denisgav/rpi_pico_w_a2dp_sink_demo/Firmware/app/usb_stereo_microphone/README.md

# USB stereo microphone
Microphone rupports several formats:
  * 24 / 16 bit samples
  * 16000 / 32000 / 48000 Hz sample rates
