denisgav/rpi_pico_w_a2dp_sink_demo/Firmware/app/usb_stereo_speaker/README.md

# USB stereo speaker
Speaker rupports several formats:
  * 24 / 16 bit samples
  * 44100 / 48000 Hz sample rates
