denisgav/rpi_pico_w_a2dp_sink_demo/KiCad/components/AudioJack_3.5mm_PJ311/AudioJack_3.5mm_PJ311.step

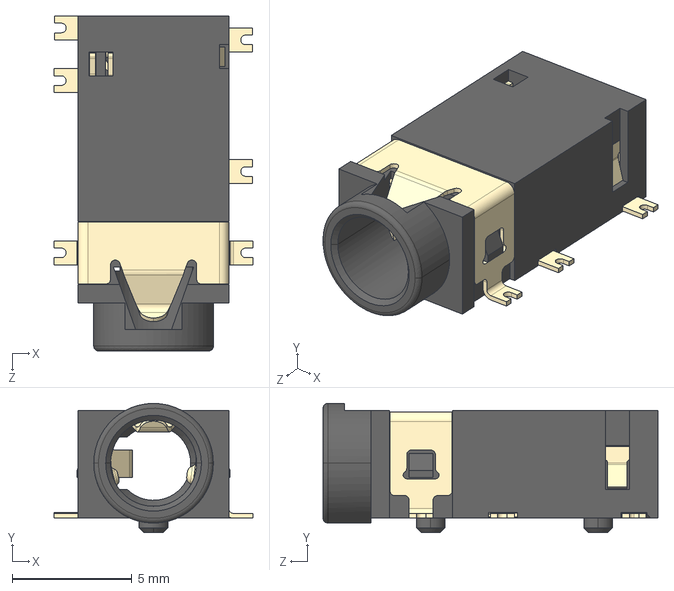
[picture p1: CAD file, 2025-04-05]
KiCad/components/AudioJack_3.5mm_PJ311/AudioJack_3.5mm_PJ311.step
8.30 x 5.40 x 14.0 mm
