denisgav/rpi_pico_w_a2dp_sink_demo/KiCad/components/CR1220-2/CR1220-2.stp

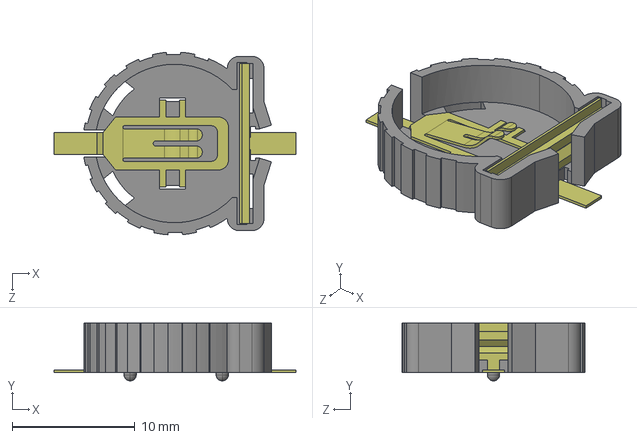
[picture p2: CAD file, 2025-04-05]
KiCad/components/CR1220-2/CR1220-2.stp
19.7 x 4.70 x 14.9 mm
