denisgav/rpi_pico_w_a2dp_sink_demo/KiCad/components/inmp441/inmp441.step

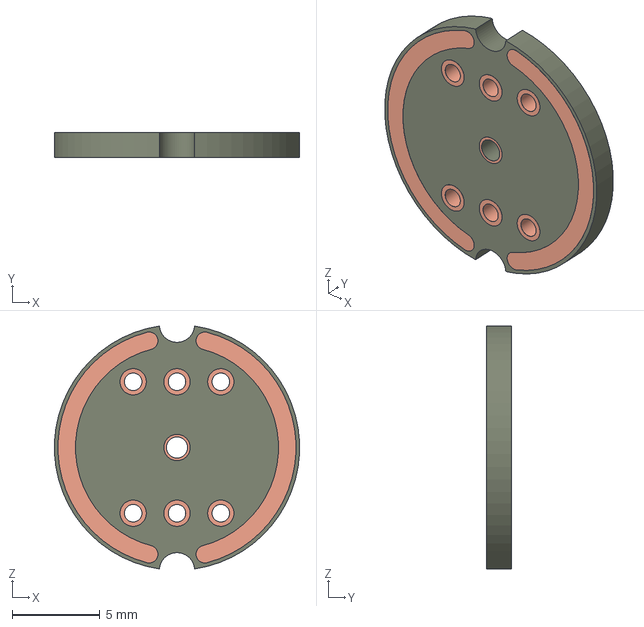
[picture p3: CAD file, 2025-04-05]
KiCad/components/inmp441/inmp441.step
14.0 x 1.41 x 13.9 mm
