denisgav/rpi_pico_w_a2dp_sink_demo/KiCad/components/Power/Barrel_Jack/BarrelJack-PJ-102AH.step

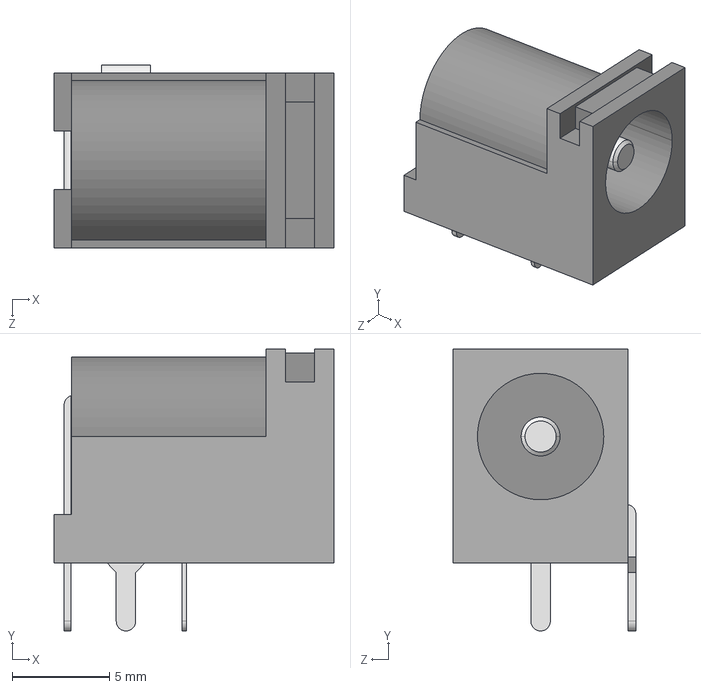
[picture p4: CAD file, 2025-04-05]
KiCad/components/Power/Barrel_Jack/BarrelJack-PJ-102AH.step
14.4 x 14.5 x 9.40 mm
