denisgav/rpi_pico_w_a2dp_sink_demo/KiCad/components/Power/LS1205EVD33/LS1205EVD33.stp

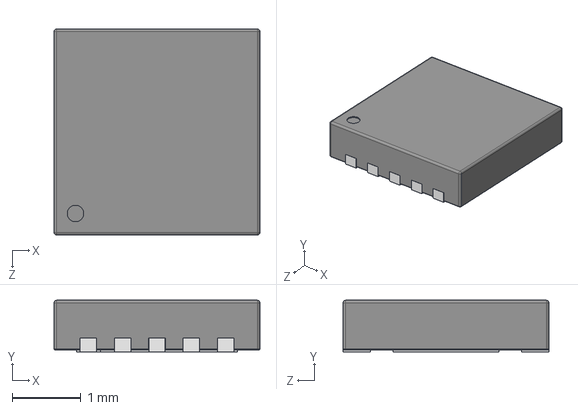
[picture p5: CAD file, 2025-04-05]
KiCad/components/Power/LS1205EVD33/LS1205EVD33.stp
3.00 x 0.75 x 3.00 mm
