denisgav/rpi_pico_w_a2dp_sink_demo/KiCad/components/Power/SY8003ADFC/SY8003ADFC.stp

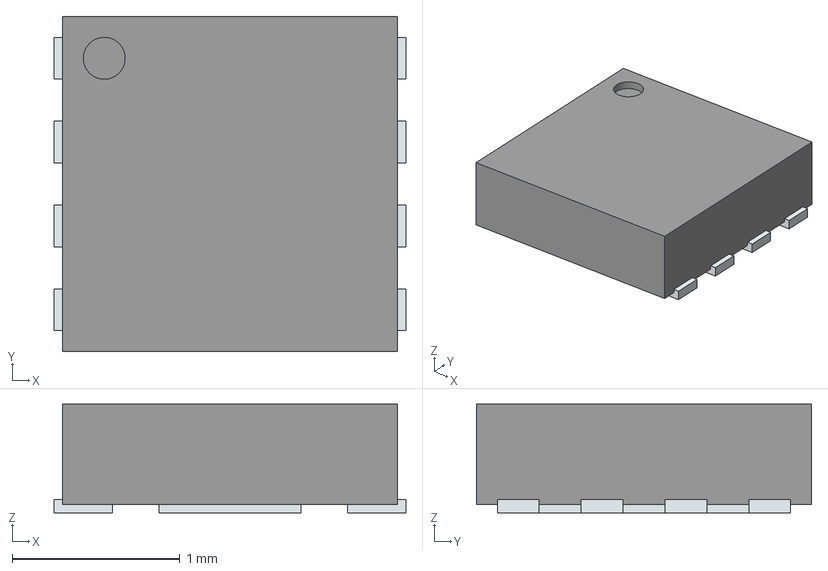
[picture p6: CAD file, 2025-04-05]
KiCad/components/Power/SY8003ADFC/SY8003ADFC.stp
2.10 x 2.00 x 0.65 mm
ThermalPin
PinsArrayLR
