denisgav/rpi_pico_w_a2dp_sink_demo/KiCad/components/sw_dpdt_xlx/SW_Btn_XLX.step

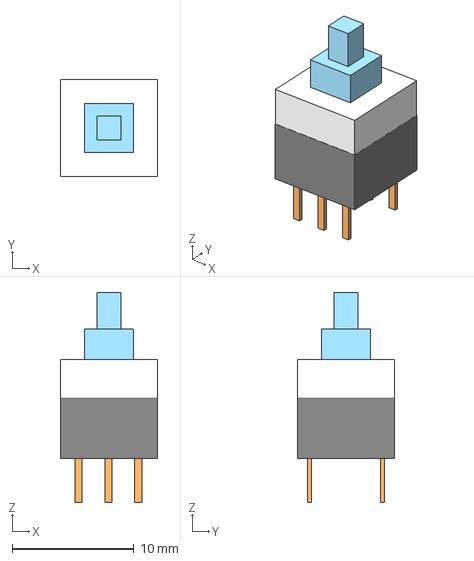
[picture p7: CAD file, 2025-04-05]
KiCad/components/sw_dpdt_xlx/SW_Btn_XLX.step
8.00 x 8.00 x 17.2 mm
