denisgav/rpi_pico_w_a2dp_sink_demo/KiCad/components/SW_PUSH_6mm_H5mm/SW_PUSH_6mm_H5mm.step

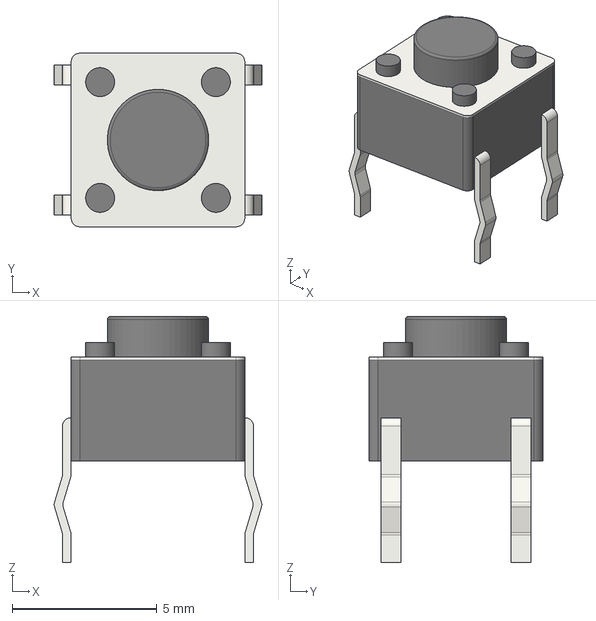
[picture p8: CAD file, 2025-04-05]
KiCad/components/SW_PUSH_6mm_H5mm/SW_PUSH_6mm_H5mm.step
7.17 x 6.00 x 8.50 mm
