denisgav/rpi_pico_w_a2dp_sink_demo/KiCad/components/TF-01A/TF-01A.stp

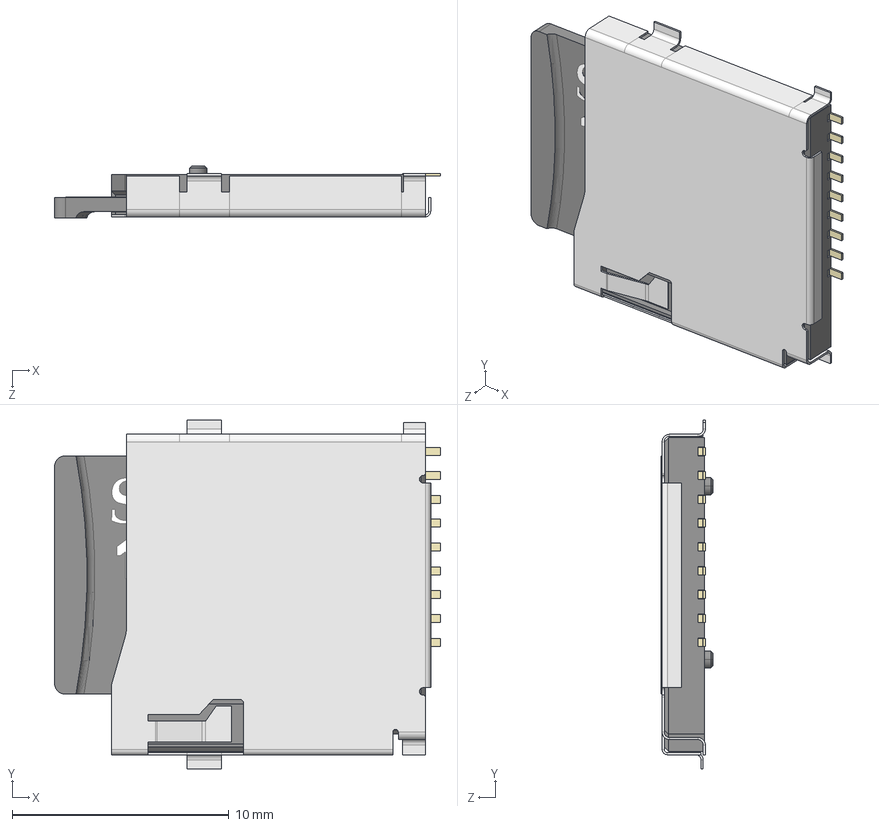
[picture p9: CAD file, 2025-04-05]
KiCad/components/TF-01A/TF-01A.stp
17.8 x 16.1 x 2.40 mm
