denisgav/rpi_pico_w_a2dp_sink_demo/KiCad/rpi_pico_media_board.kicad_pcb

## KiCad design KiCad/rpi_pico_media_board.kicad_pcb (2025-05-18)

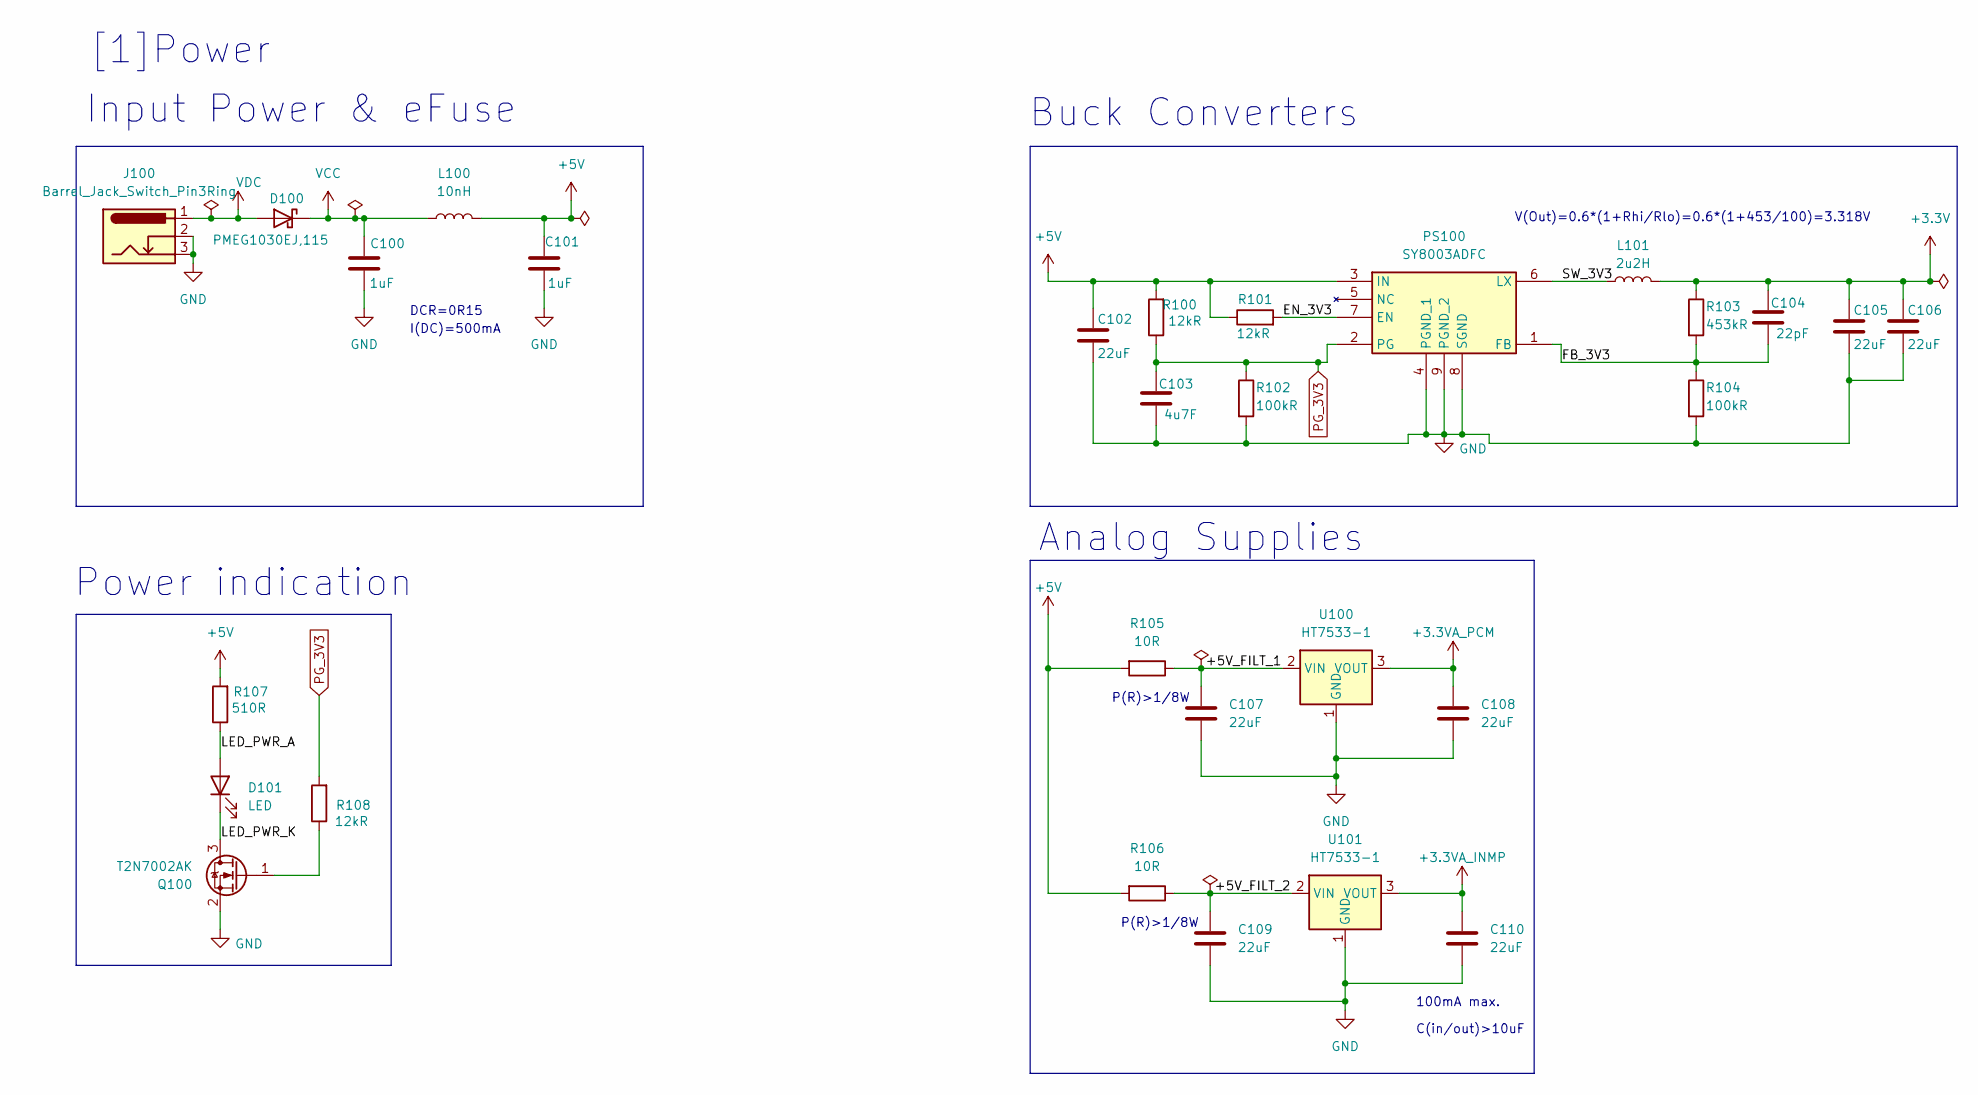
[picture p10: schematic [1]Power.kicad_sch]

Parts:
C100, C101: 1uF; C_0603_1608Metric; Manufacturer Part Number CL10A105KB8NNNC
C102, C105, C106, C107, C108, C109, C110: 22uF; C_1206_3216Metric; Manufacturer Part Number CS3216X5R226M160NRI
C103: 4u7F; C_0603_1608Metric; Manufacturer Part Number CL10A475KP8NNNC
C104: 22pF; C_0603_1608Metric; Manufacturer Part Number CL10C220JB8NNNC
D100: PMEG1030EJ,115; D_SOD-323F; Manufacturer Part Number PMEG1030EJ,115
D101: LED; LED_0603_1608Metric; Manufacturer Part Number XL-1608SURC-06
J100: Barrel_Jack_Switch_Pin3Ring; BarrelJack_GCT_DCJ200-10-A_Horizontal; Manufacturer Part Number DC005
L100: 10nH; L_0603_1608Metric; Manufacturer Part Number LQW18AN10NG10D
L101: 2u2H; L_1008_2520Metric; Manufacturer Part Number DFE252012F-2R2M=P2
PS100: SY8003ADFC; SON50P200X200X65-9N; Manufacturer Part Number SY8003ADFC
Q100: T2N7002AK; SOT-23; Manufacturer Part Number T2N7002AK,LM
R100, R101, R108: 12kR; R_0603_1608Metric; Manufacturer Part Number 0603WAF1202T5E
R102, R104: 100kR; R_0603_1608Metric; Manufacturer Part Number 0603WAF1003T5E
R103: 453kR; R_0603_1608Metric; Manufacturer Part Number 0603WAF4533T5E
R105, R106: 10R; R_0805_2012Metric; Manufacturer Part Number 0805W8F100JT5E
R107: 510R; R_0603_1608Metric; Manufacturer Part Number 0603WAF5100T5E
U100, U101: HT7533-1; SOT-89-3; Manufacturer Part Number HT7533-1

Connections:
+3.3V: C104.1, C105.1, C106.1, L101.2, R103.1; also elsewhere on the board
+3.3VA_INMP: C110.1, U101.3 (VOUT); also elsewhere on the board
+3.3VA_PCM: C108.1, U100.3 (VOUT); also elsewhere on the board
+5V: C101.1, C102.1, L100.2, PS100.3 (IN), R100.2, R101.1, R105.2, R106.2, R107.2; also elsewhere on the board
/[1]Power/+5V_FILT_1: C107.1, R105.1, U100.2 (VIN)
/[1]Power/+5V_FILT_2: C109.1, R106.1, U101.2 (VIN)
/[1]Power/EN_3V3: PS100.7 (EN), R101.2
/[1]Power/FB_3V3: C104.2, PS100.1 (FB), R103.2, R104.1
/[1]Power/LED_PWR_A: D101.2 (A), R107.1
/[1]Power/LED_PWR_K: D101.1 (K), Q100.3 (D)
/[1]Power/SW_3V3: L101.1, PS100.6 (LX)
GND: C100.2, C101.2, C102.2, C103.2, C105.2, C106.2, C107.2, C108.2, C109.2, C110.2, J100.2, J100.3, PS100.4 (PGND_1), PS100.8 (SGND), PS100.9 (PGND_2), Q100.2 (S), R102.2, R104.2, U100.1 (GND), U101.1 (GND); also elsewhere on the board
unnamed: Q100.1 (G), R108.1
PG_3V3: C103.1, PS100.2 (PG), R100.1, R102.1, R108.2
VCC: C100.1, D100.1 (K), L100.1; also elsewhere on the board
VDC: D100.2 (A), J100.1

Notes on the sheet:
Analog Supplies
Power indication
P(R)>1/8W
I(DC)=500mA
Input Power & eFuse
100mA max.
[1]Power
DCR=0R15
C(in/out)>10uF
V(Out)=0.6*(1+Rhi/Rlo)=0.6*(1+453/100)=3.318V
Buck Converters

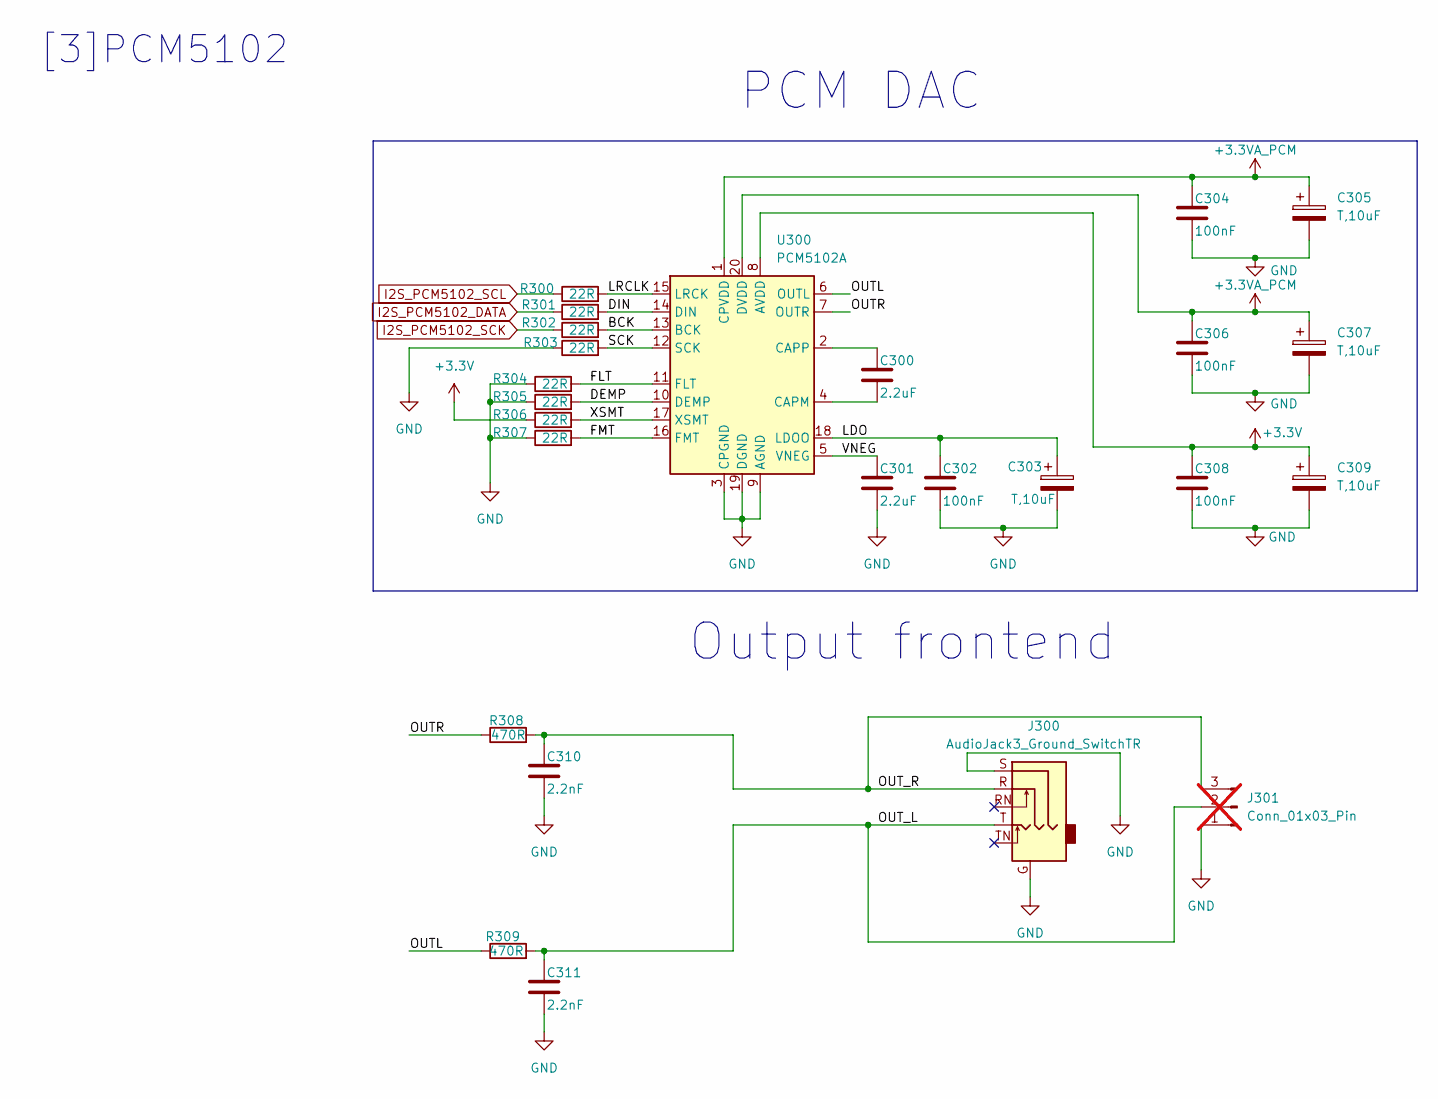
[picture p11: schematic [3]PCM5102.kicad_sch]

Parts:
C300, C301: 2.2uF; C_0603_1608Metric; Manufacturer Part Number CL10A225KA8NNNC
C302, C304, C306, C308: 100nF; C_0603_1608Metric; Manufacturer Part Number CL10B104KA8NNNC
C303, C305, C307, C309: T,10uF; CP_EIA-3216-18_Kemet-A; Manufacturer Part Number TAJA106K016RNJ
C310, C311: 2.2nF; C_0603_1608Metric; Manufacturer Part Number CL10B222KB8NNNC
J300: AudioJack3_Ground_SwitchTR; AudioJack_3.5mm_PJ311; Manufacturer Part Number PJ-342
J301: Conn_01x03_Pin; PinHeader_1x03_P2.54mm_Vertical; not fitted
R300, R301, R302, R303, R304, R305, R306, R307: 22R; R_0603_1608Metric; Manufacturer Part Number 0603WAF220JT5E
R308, R309: 470R; R_0805_2012Metric; Manufacturer Part Number ARG05FTC4700
U300: PCM5102A; TSSOP-20_4.4x6.5mm_P0.65mm; Manufacturer Part Number PCM5102AQPWRQ1

Connections:
+3.3V: C308.1, C309.1, R306.1, U300.8 (AVDD); also elsewhere on the board
+3.3VA_PCM: C304.1, C305.1, C306.1, C307.1, U300.1 (CPVDD), U300.20 (DVDD); also elsewhere on the board
/[3]PCM5102/BCK: R302.2, U300.13 (BCK)
/[3]PCM5102/DEMP: R305.2, U300.10 (DEMP)
/[3]PCM5102/DIN: R301.2, U300.14 (DIN)
/[3]PCM5102/FLT: R304.2, U300.11 (FLT)
/[3]PCM5102/FMT: R307.2, U300.16 (FMT)
/[3]PCM5102/LDO: C302.1, C303.1, U300.18 (LDOO)
/[3]PCM5102/LRCLK: R300.2, U300.15 (LRCK)
/[3]PCM5102/OUTL: R309.1, U300.6 (OUTL)
/[3]PCM5102/OUTR: R308.1, U300.7 (OUTR)
/[3]PCM5102/OUT_L: C311.1, J300.T, J301.2, R309.2
/[3]PCM5102/OUT_R: C310.1, J300.R, J301.3, R308.2
/[3]PCM5102/SCK: R303.2, U300.12 (SCK)
/[3]PCM5102/VNEG: C301.1, U300.5 (VNEG)
/[3]PCM5102/XSMT: R306.2, U300.17 (XSMT)
GND: C301.2, C302.2, C303.2, C304.2, C305.2, C306.2, C307.2, C308.2, C309.2, C310.2, C311.2, J300.G, J300.S, J301.1, R303.1, R304.1, R305.1, R307.1, U300.3 (CPGND), U300.9 (AGND), U300.19 (DGND); also elsewhere on the board
I2S_PCM5102_DATA: R301.1; also elsewhere on the board
I2S_PCM5102_SCK: R302.1; also elsewhere on the board
I2S_PCM5102_SCL: R300.1; also elsewhere on the board
unnamed: C300.2, U300.4 (CAPM)
unnamed: C300.1, U300.2 (CAPP)

Notes on the sheet:
[3]PCM5102
Output frontend
PCM DAC

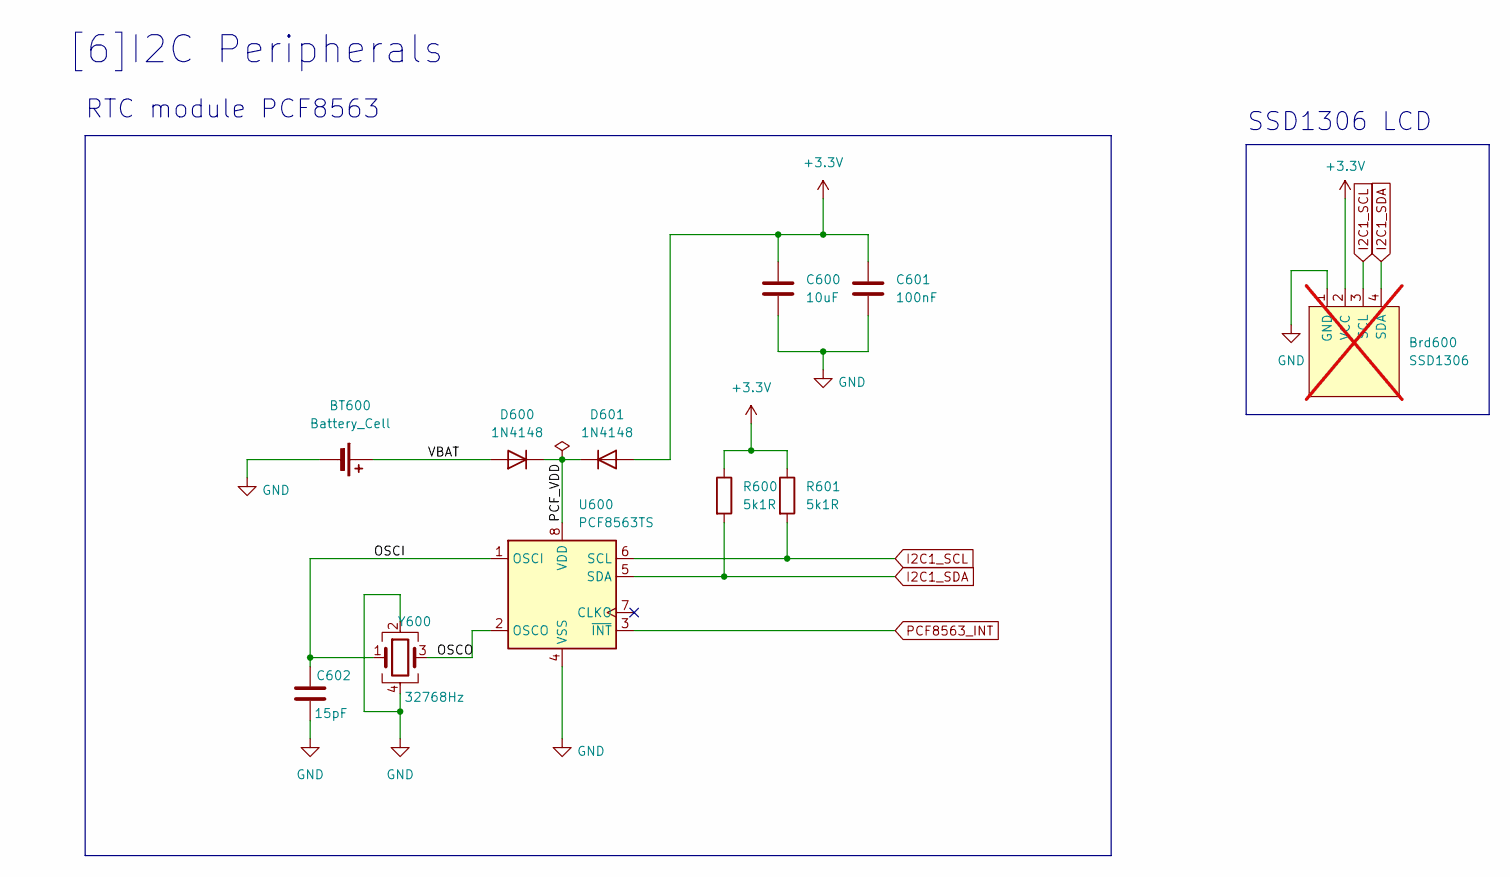
[picture p12: schematic [6]I2C_Peripherals.kicad_sch]

Parts:
BT600: Battery_Cell; CR12202; Manufacturer Part Number CR1220-2
Brd600: SSD1306; 128x64OLED; not fitted
C600: 10uF; C_0603_1608Metric; Manufacturer Part Number CL10A106KP8NNNC
C601: 100nF; C_0603_1608Metric; Manufacturer Part Number CL10B104KA8NNNC
C602: 15pF; C_0603_1608Metric; Manufacturer Part Number CL10C150JB8NNNC; DigiKey Part Number 490-11191-6-ND
D600, D601: 1N4148; D_SOD-123; Manufacturer Part Number 1N4148W
R600, R601: 5k1R; R_0805_2012Metric; Manufacturer Part Number 0805W8F5101T5E
U600: PCF8563TS; MSOP-8_3x3mm_P0.65mm; Manufacturer Part Number PCF8563TS/5,118
Y600: 32768Hz; Crystal_SMD_3225-4Pin_3.2x2.5mm; Manufacturer Part Number OK2EL89CJI-111YLC-32.768K; DigiKey Part Number 535-ASEK-32.768KHZ-L-R-TDKR-ND

Connections:
+3.3V: Brd600.2 (VCC), C600.1, C601.1, D601.2 (A), R600.1, R601.1; also elsewhere on the board
/[6]I2C_Peripherals/OSCI: C602.1, U600.1 (OSCI), Y600.1
/[6]I2C_Peripherals/OSCO: U600.2 (OSCO), Y600.3
/[6]I2C_Peripherals/PCF_VDD: D600.1 (K), D601.1 (K), U600.8 (VDD)
/[6]I2C_Peripherals/VBAT: BT600.1 (+), D600.2 (A)
GND: BT600.2 (-), Brd600.1 (GND), C600.2, C601.2, C602.2, U600.4 (VSS), Y600.2, Y600.4; also elsewhere on the board
I2C1_SCL: Brd600.3 (SCL), R601.2, U600.6 (SCL); also elsewhere on the board
I2C1_SDA: Brd600.4 (SDA), R600.2, U600.5 (SDA); also elsewhere on the board
PCF8563_INT: U600.3 (~INT); also elsewhere on the board

Notes on the sheet:
[6]I2C Peripherals
SSD1306 LCD
RTC module PCF8563

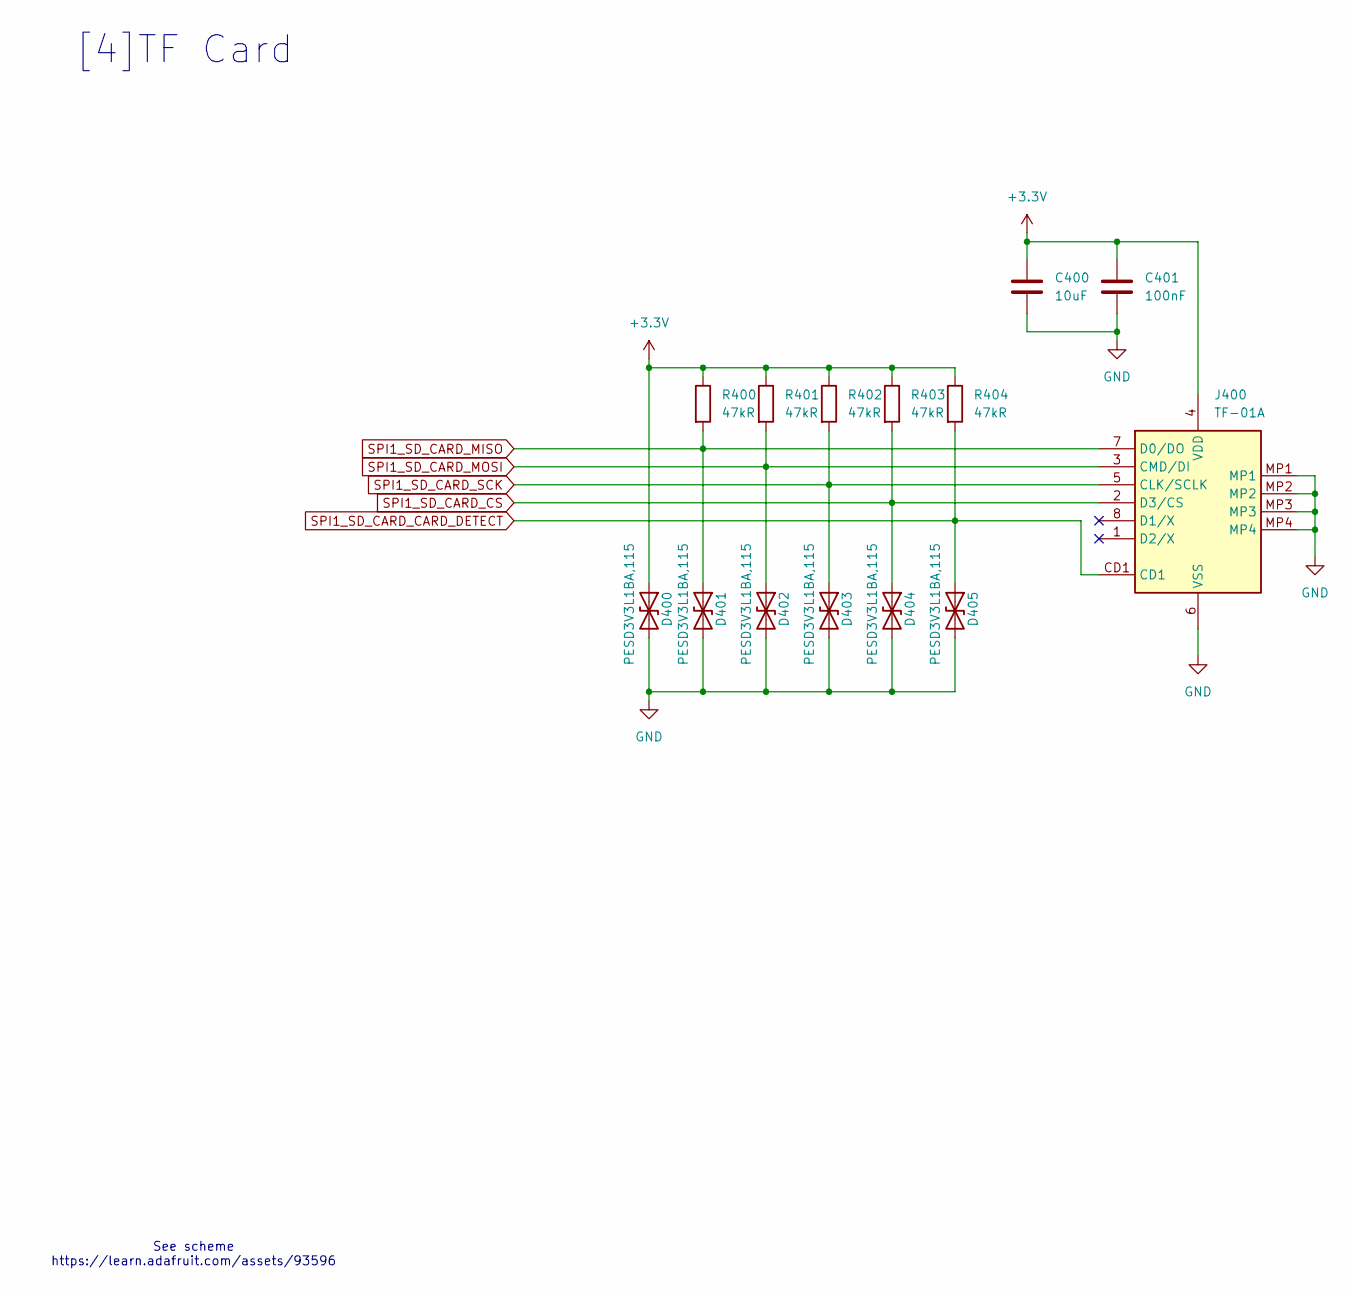
[picture p13: schematic [4]TF_CARD.kicad_sch]

Parts:
C400: 10uF; C_0603_1608Metric; Manufacturer Part Number CL10A106KP8NNNC
C401: 100nF; C_0603_1608Metric; Manufacturer Part Number CL10B104KA8NNNC
D400, D401, D402, D403, D404, D405: PESD3V3L1BA,115; D_SOD-323; Manufacturer Part Number PESD3V3L1BA,115
J400: TF-01A; TF01A; Manufacturer Part Number TF-01A
R400, R401, R402, R403, R404: 47kR; R_0603_1608Metric; Manufacturer Part Number 0603WAJ0473T5E

Connections:
+3.3V: C400.1, C401.1, D400.1 (A1), J400.4 (VDD), R400.1, R401.1, R402.1, R403.1, R404.1; also elsewhere on the board
GND: C400.2, C401.2, D400.2 (A2), D401.2 (A2), D402.2 (A2), D403.2 (A2), D404.2 (A2), D405.2 (A2), J400.6 (VSS), J400.MP1, J400.MP2, J400.MP3, J400.MP4; also elsewhere on the board
SPI1_SD_CARD_CARD_DETECT: D405.1 (A1), J400.CD1, R404.2; also elsewhere on the board
SPI1_SD_CARD_CS: D404.1 (A1), J400.2 (D3/CS), R403.2; also elsewhere on the board
SPI1_SD_CARD_MISO: D401.1 (A1), J400.7 (D0/DO), R400.2; also elsewhere on the board
SPI1_SD_CARD_MOSI: D402.1 (A1), J400.3 (CMD/DI), R401.2; also elsewhere on the board
SPI1_SD_CARD_SCK: D403.1 (A1), J400.5 (CLK/SCLK), R402.2; also elsewhere on the board

Notes on the sheet:
See scheme https://learn.adafruit.com/assets/93596
[4]TF Card

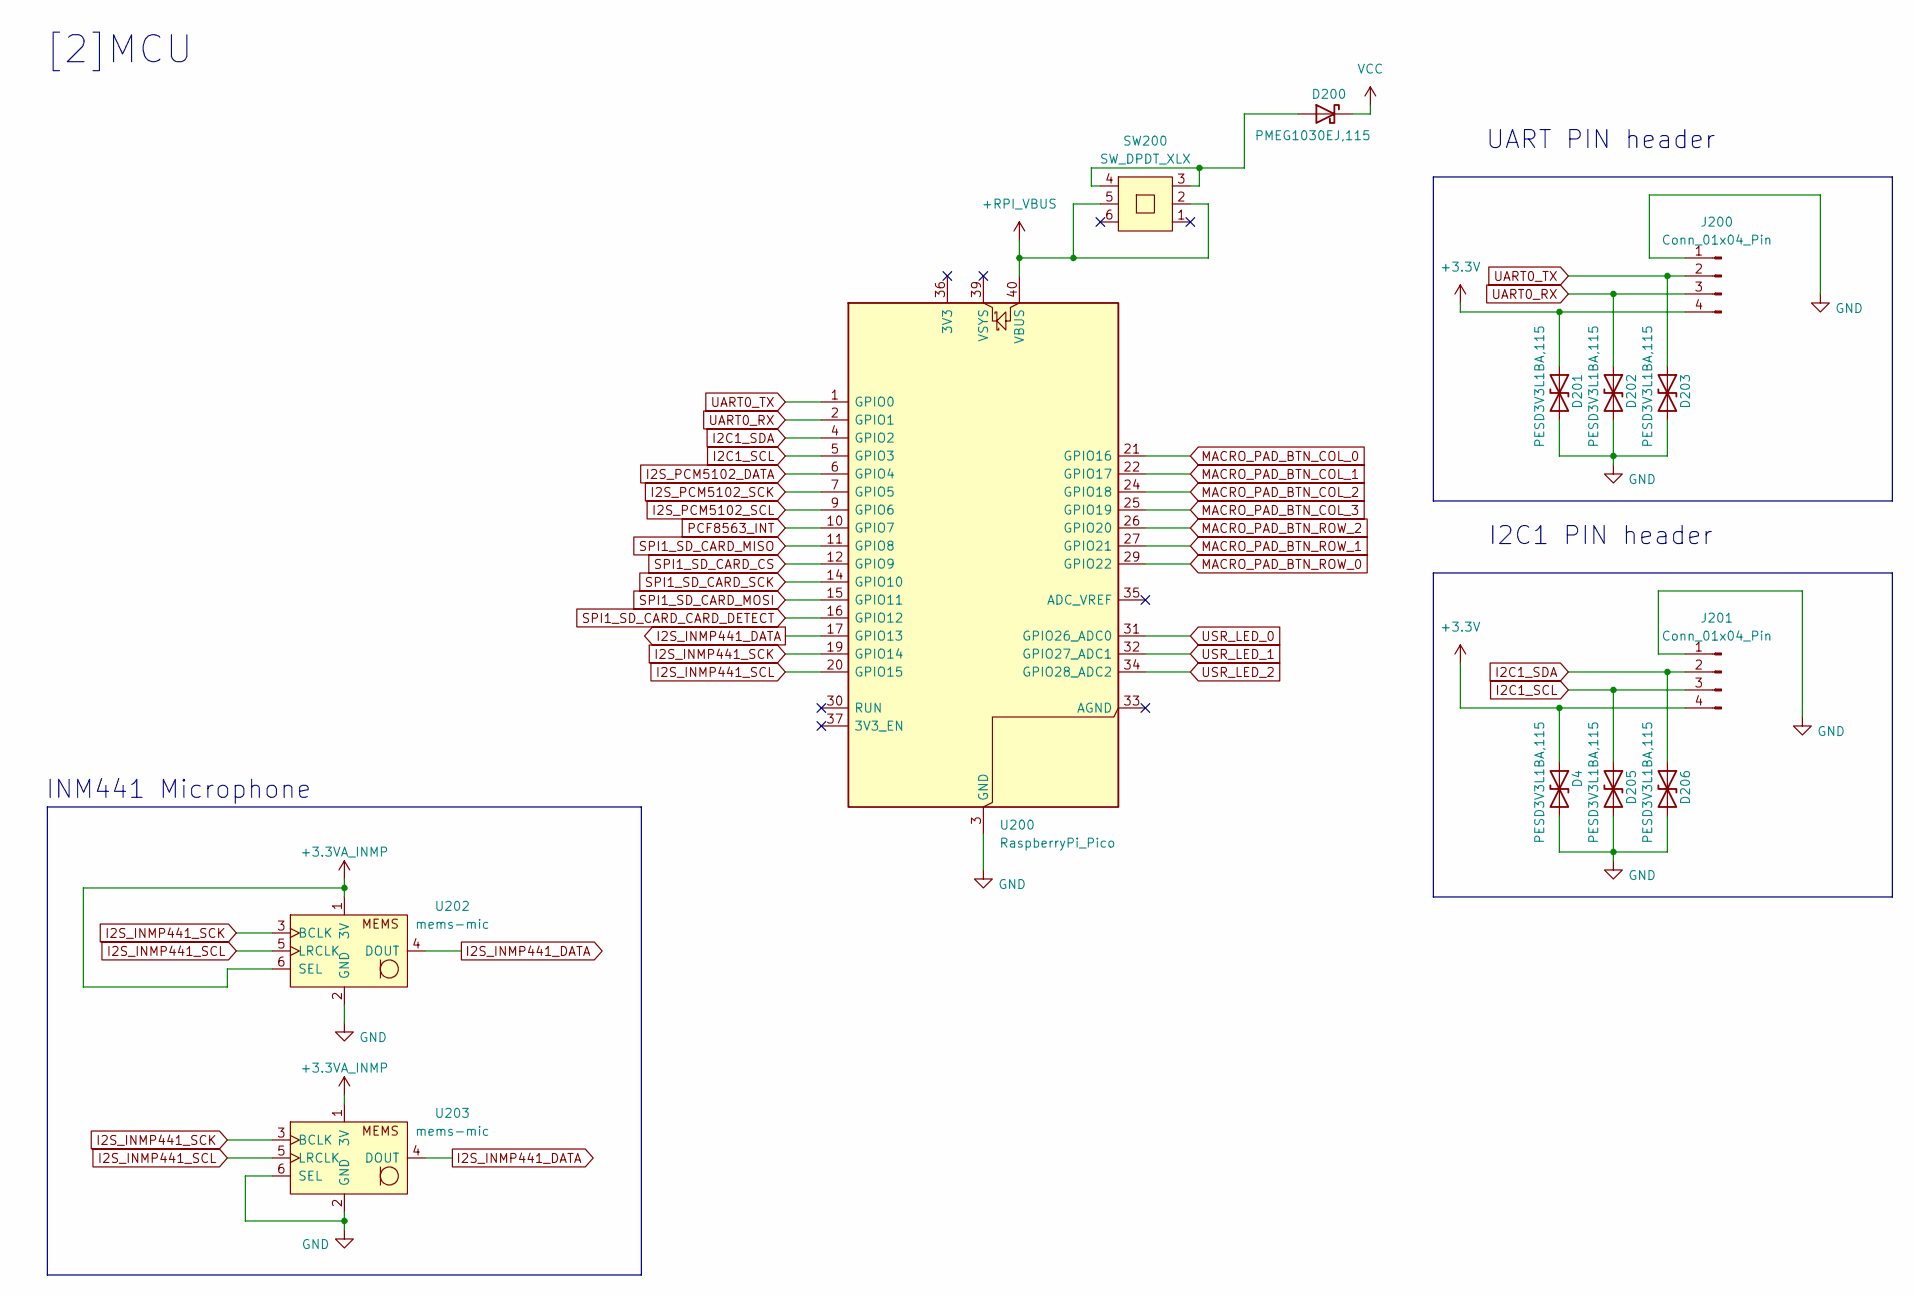
[picture p14: schematic [2]MCU.kicad_sch]

Parts:
D4, D201, D202, D203, D205, D206: PESD3V3L1BA,115; D_SOD-323; Manufacturer Part Number PESD3V3L1BA,115
D200: PMEG1030EJ,115; D_SOD-323F; Manufacturer Part Number PMEG1030EJ,115
J200, J201: Conn_01x04_Pin; PinHeader_1x04_P2.54mm_Vertical
SW200: SW_DPDT_XLX
U200: RaspberryPi_Pico; RaspberryPi_Pico_Common_THT
U202, U203: mems-mic; inmp441

Connections:
+3.3V: D4.1 (A1), D201.1 (A1), J200.4, J201.4; also elsewhere on the board
+3.3VA_INMP: U202.1 (3V), U202.6 (SEL), U203.1 (3V); also elsewhere on the board
+RPI_VBUS: SW200.2, SW200.5, U200.40 (VBUS)
GND: D4.2 (A2), D201.2 (A2), D202.2 (A2), D203.2 (A2), D205.2 (A2), D206.2 (A2), J200.1, J201.1, U200.3 (GND), U200.8 (GND), U200.13 (GND), U200.18 (GND), U200.23 (GND), U200.28 (GND), U200.38 (GND), U202.2 (GND), U203.2 (GND), U203.6 (SEL); also elsewhere on the board
I2C1_SCL: D205.1 (A1), J201.3, U200.5 (GPIO3); also elsewhere on the board
I2C1_SDA: D206.1 (A1), J201.2, U200.4 (GPIO2); also elsewhere on the board
I2S_INMP441_DATA: U200.17 (GPIO13), U202.4 (DOUT), U203.4 (DOUT)
I2S_INMP441_SCK: U200.19 (GPIO14), U202.3 (BCLK), U203.3 (BCLK)
I2S_INMP441_SCL: U200.20 (GPIO15), U202.5 (LRCLK), U203.5 (LRCLK)
I2S_PCM5102_DATA: U200.6 (GPIO4); also elsewhere on the board
I2S_PCM5102_SCK: U200.7 (GPIO5); also elsewhere on the board
I2S_PCM5102_SCL: U200.9 (GPIO6); also elsewhere on the board
MACRO_PAD_BTN_COL_0: U200.21 (GPIO16); also elsewhere on the board
MACRO_PAD_BTN_COL_1: U200.22 (GPIO17); also elsewhere on the board
MACRO_PAD_BTN_COL_2: U200.24 (GPIO18); also elsewhere on the board
MACRO_PAD_BTN_COL_3: U200.25 (GPIO19); also elsewhere on the board
MACRO_PAD_BTN_ROW_0: U200.29 (GPIO22); also elsewhere on the board
MACRO_PAD_BTN_ROW_1: U200.27 (GPIO21); also elsewhere on the board
MACRO_PAD_BTN_ROW_2: U200.26 (GPIO20); also elsewhere on the board
unnamed: D200.2 (A), SW200.3, SW200.4
PCF8563_INT: U200.10 (GPIO7); also elsewhere on the board
SPI1_SD_CARD_CARD_DETECT: U200.16 (GPIO12); also elsewhere on the board
SPI1_SD_CARD_CS: U200.12 (GPIO9); also elsewhere on the board
SPI1_SD_CARD_MISO: U200.11 (GPIO8); also elsewhere on the board
SPI1_SD_CARD_MOSI: U200.15 (GPIO11); also elsewhere on the board
SPI1_SD_CARD_SCK: U200.14 (GPIO10); also elsewhere on the board
UART0_RX: D202.1 (A1), J200.3, U200.2 (GPIO1)
UART0_TX: D203.1 (A1), J200.2, U200.1 (GPIO0)
USR_LED_0: U200.31 (GPIO26_ADC0); also elsewhere on the board
USR_LED_1: U200.32 (GPIO27_ADC1); also elsewhere on the board
USR_LED_2: U200.34 (GPIO28_ADC2); also elsewhere on the board
VCC: D200.1 (K); also elsewhere on the board

Notes on the sheet:
INM441 Microphone
UART PIN header
I2C1 PIN header
[2]MCU

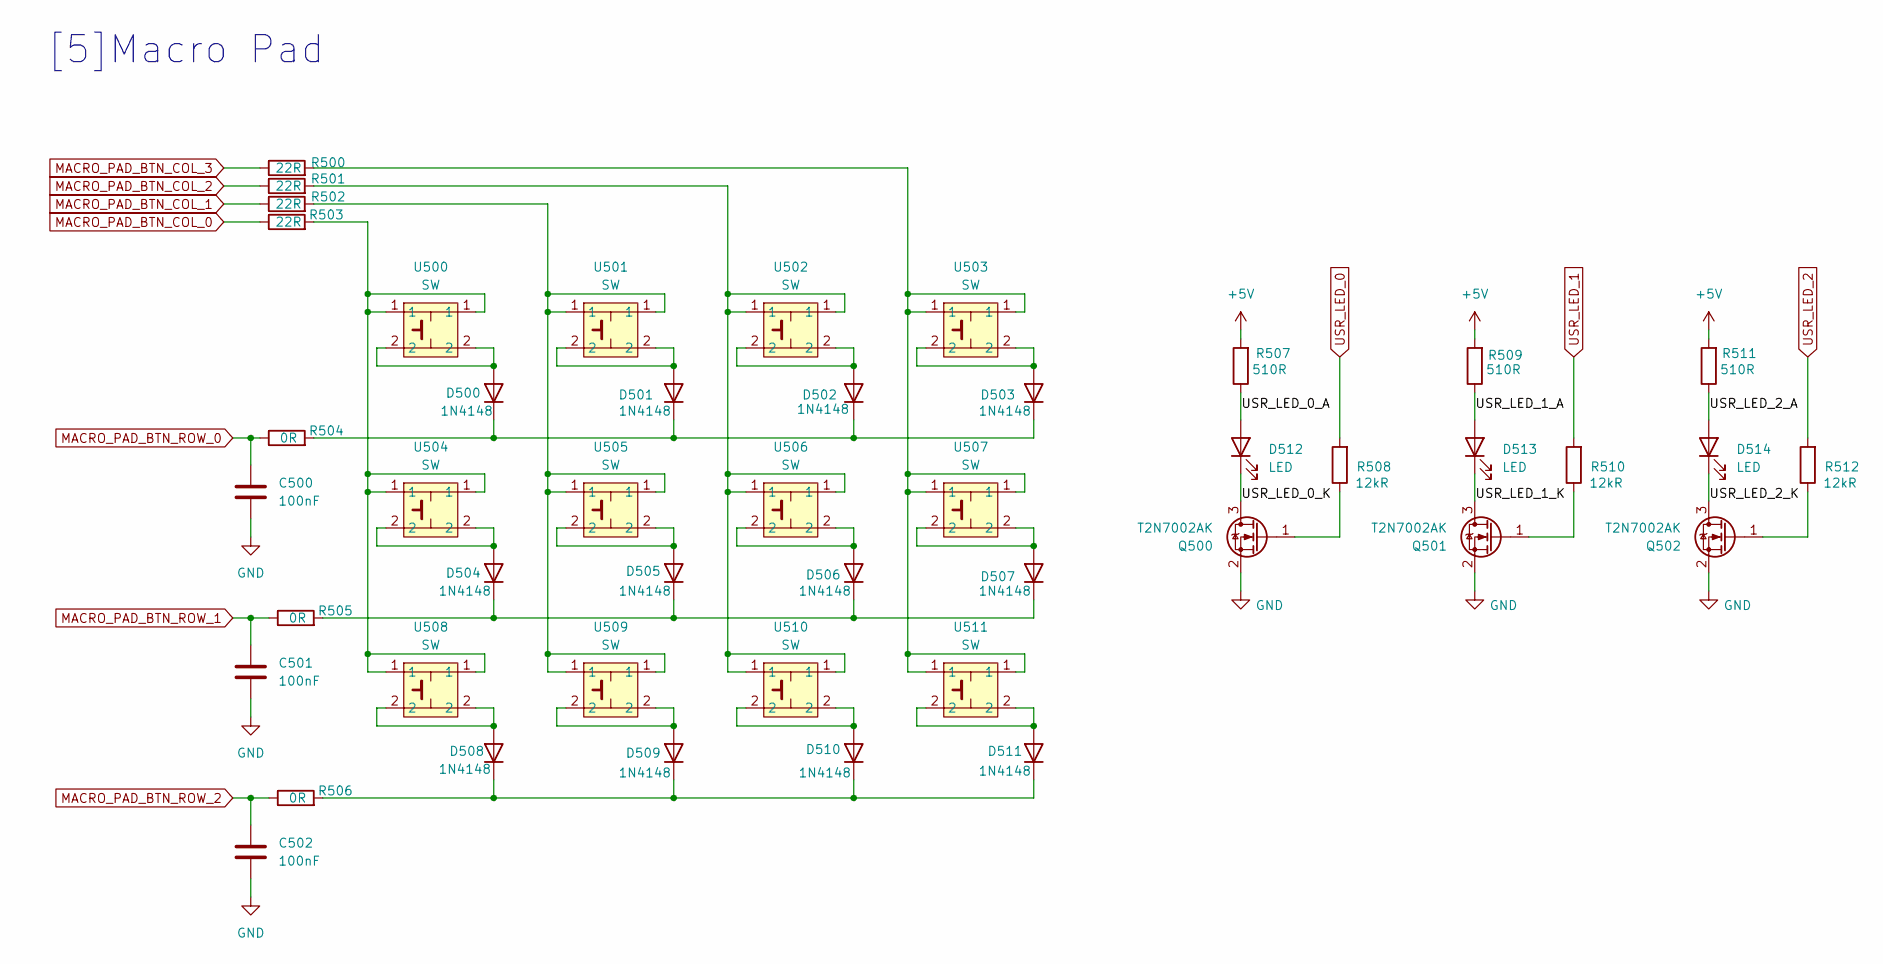
[picture p15: schematic [5]Macro_Pad.kicad_sch]

Parts:
C500, C501, C502: 100nF; C_0603_1608Metric; Manufacturer Part Number CL10B104KA8NNNC
D500, D501, D502, D503, D504, D505, D506, D507, D508, D509, D510, D511: 1N4148; D_SOD-123; Manufacturer Part Number 1N4148W
D512, D513, D514: LED; LED_0603_1608Metric; Manufacturer Part Number XL-1608SURC-06
Q500, Q501, Q502: T2N7002AK; SOT-23; Manufacturer Part Number T2N7002AK,LM
R500, R501, R502, R503: 22R; R_0603_1608Metric; Manufacturer Part Number 0603WAF220JT5E
R504, R505, R506: 0R; R_0603_1608Metric; Manufacturer Part Number 0603WAF0000T5E
R507, R509, R511: 510R; R_0603_1608Metric; Manufacturer Part Number 0603WAF5100T5E
R508, R510, R512: 12kR; R_0603_1608Metric; Manufacturer Part Number 0603WAF1202T5E
U500, U501, U502, U503, U504, U505, U506, U507, U508, U509, U510, U511: SW; SW_PUSH_6mm_H5mm; Manufacturer Part Number SMG-01-H080A1

Connections:
+5V: R507.2, R509.2, R511.2; also elsewhere on the board
/[5]Macro_Pad/USR_LED_0_A: D512.2 (A), R507.1
/[5]Macro_Pad/USR_LED_0_K: D512.1 (K), Q500.3 (D)
/[5]Macro_Pad/USR_LED_1_A: D513.2 (A), R509.1
/[5]Macro_Pad/USR_LED_1_K: D513.1 (K), Q501.3 (D)
/[5]Macro_Pad/USR_LED_2_A: D514.2 (A), R511.1
/[5]Macro_Pad/USR_LED_2_K: D514.1 (K), Q502.3 (D)
GND: C500.2, C501.2, C502.2, Q500.2 (S), Q501.2 (S), Q502.2 (S); also elsewhere on the board
MACRO_PAD_BTN_COL_0: R503.1; also elsewhere on the board
MACRO_PAD_BTN_COL_1: R502.1; also elsewhere on the board
MACRO_PAD_BTN_COL_2: R501.1; also elsewhere on the board
MACRO_PAD_BTN_COL_3: R500.1; also elsewhere on the board
MACRO_PAD_BTN_ROW_0: C500.1, R504.1; also elsewhere on the board
MACRO_PAD_BTN_ROW_1: C501.1, R505.1; also elsewhere on the board
MACRO_PAD_BTN_ROW_2: C502.1, R506.1; also elsewhere on the board
unnamed: D500.2 (A), U500.2
unnamed: D500.1 (K), D501.1 (K), D502.1 (K), D503.1 (K), R504.2
unnamed: D501.2 (A), U501.2
unnamed: D502.2 (A), U502.2
unnamed: D503.2 (A), U503.2
unnamed: D504.2 (A), U504.2
unnamed: D504.1 (K), D505.1 (K), D506.1 (K), D507.1 (K), R505.2
unnamed: D505.2 (A), U505.2
unnamed: D506.2 (A), U506.2
unnamed: D507.2 (A), U507.2
unnamed: D508.2 (A), U508.2
unnamed: D508.1 (K), D509.1 (K), D510.1 (K), D511.1 (K), R506.2
unnamed: D509.2 (A), U509.2
unnamed: D510.2 (A), U510.2
unnamed: D511.2 (A), U511.2
unnamed: Q500.1 (G), R508.1
unnamed: Q501.1 (G), R510.1
unnamed: Q502.1 (G), R512.1
unnamed: R500.2, U503.1, U507.1, U511.1
unnamed: R501.2, U502.1, U506.1, U510.1
unnamed: R502.2, U501.1, U505.1, U509.1
unnamed: R503.2, U500.1, U504.1, U508.1
USR_LED_0: R508.2; also elsewhere on the board
USR_LED_1: R510.2; also elsewhere on the board
USR_LED_2: R512.2; also elsewhere on the board

Notes on the sheet:
[5]Macro Pad

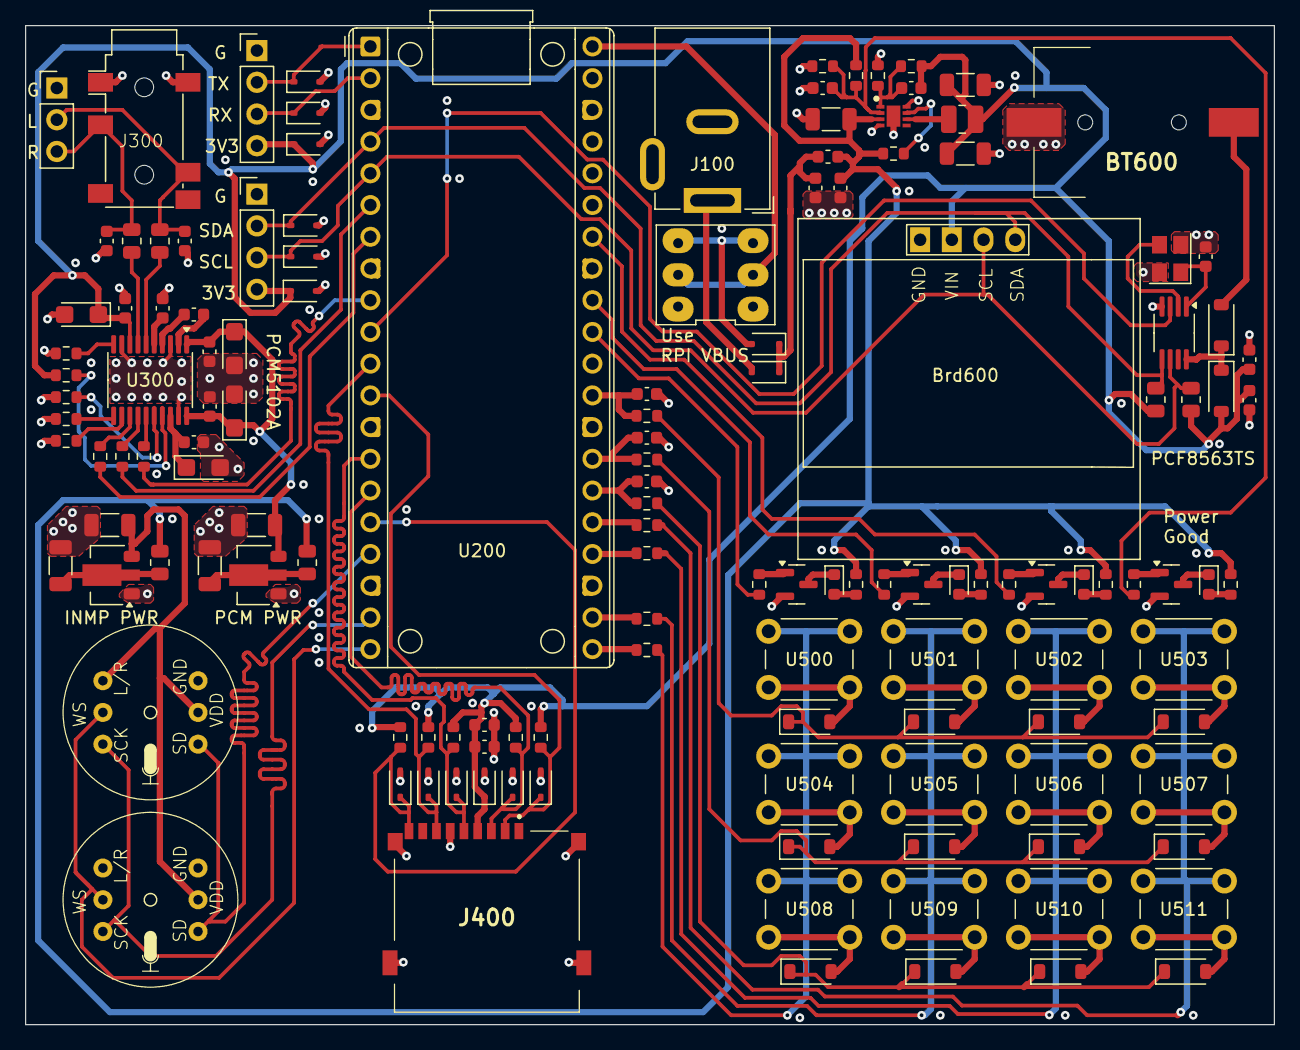
[picture p16: board rpi_pico_media_board.kicad_pcb from above]

Board: 4 copper layers, 100.0 x 80.0 mm, 138 parts (0 on the bottom side), 92 nets.
