denisgav/rpi_pico_w_a2dp_sink_demo/Firmware/app/bt_a2dp_sink/src/btstack_audio_pico.c

/*
 * Copyright (C) 2022 BlueKitchen GmbH
 *
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
 * 1. Redistributions of source code must retain the above copyright
 *    notice, this list of conditions and the following disclaimer.
 * 2. Redistributions in binary form must reproduce the above copyright
 *    notice, this list of conditions and the following disclaimer in the
 *    documentation and/or other materials provided with the distribution.
 * 3. Neither the name of the copyright holders nor the names of
 *    contributors may be used to endorse or promote products derived
 *    from this software without specific prior written permission.
 * 4. Any redistribution, use, or modification is done solely for
 *    personal benefit and not for any commercial purpose or for
 *    monetary gain.
 *
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
 * Please inquire about commercial licensing options at 
 * contact@bluekitchen-gmbh.com
 *
 */

#define BTSTACK_FILE__ "btstack_audio_pico.c"

/*
 *  btstack_audio_pico.c
 *
 *  Implementation of btstack_audio.h using pico_i2s
 *
 */

 #include <stdio.h>
 #include "pico/stdlib.h"

#include "btstack_config.h"

#include "btstack_debug.h"
#include "btstack_audio.h"
#include "btstack_run_loop.h"

#include <stddef.h>
#include <hardware/dma.h>

#include "pico/audio_i2s.h"

#define DRIVER_POLL_INTERVAL_MS          5
#define SAMPLES_PER_BUFFER 512

// client
static void (*playback_callback)(int16_t * buffer, uint16_t num_samples);

// timer to fill output ring buffer
static btstack_timer_source_t  driver_timer_sink;


static bool btstack_audio_pico_sink_active;

// from pico-playground/audio/sine_wave/sine_wave.c

static audio_format_t        btstack_audio_pico_audio_format;
static audio_buffer_format_t btstack_audio_pico_producer_format;
static audio_buffer_pool_t * btstack_audio_pico_audio_buffer_pool;
static uint8_t               btstack_audio_pico_channel_count;

uint8_t btstack_audio_pico_volume = 100;
uint16_t btstack_audio_pico_volume_db = 0x7fff;

// todo this seemed like aood guess, but is not correct
uint16_t db_to_vol[91] = {
    0x0001, 0x0001, 0x0001, 0x0001, 0x0001, 0x0001, 0x0002, 0x0002,
    0x0002, 0x0002, 0x0003, 0x0003, 0x0004, 0x0004, 0x0005, 0x0005,
    0x0006, 0x0007, 0x0008, 0x0009, 0x000a, 0x000b, 0x000d, 0x000e,
    0x0010, 0x0012, 0x0014, 0x0017, 0x001a, 0x001d, 0x0020, 0x0024,
    0x0029, 0x002e, 0x0033, 0x003a, 0x0041, 0x0049, 0x0052, 0x005c,
    0x0067, 0x0074, 0x0082, 0x0092, 0x00a4, 0x00b8, 0x00ce, 0x00e7,
    0x0104, 0x0124, 0x0147, 0x016f, 0x019c, 0x01ce, 0x0207, 0x0246,
    0x028d, 0x02dd, 0x0337, 0x039b, 0x040c, 0x048a, 0x0518, 0x05b7,
    0x066a, 0x0732, 0x0813, 0x090f, 0x0a2a, 0x0b68, 0x0ccc, 0x0e5c,
    0x101d, 0x1214, 0x1449, 0x16c3, 0x198a, 0x1ca7, 0x2026, 0x2413,
    0x287a, 0x2d6a, 0x32f5, 0x392c, 0x4026, 0x47fa, 0x50c3, 0x5a9d,
    0x65ac, 0x7214, 0x7fff
};

static int btstack_audio_pico_sink_init(
    uint8_t channels,
    uint32_t samplerate, 
    void (*playback)(int16_t * buffer, uint16_t num_samples)
);

static void btstack_audio_pico_sink_set_volume(uint8_t volume);

static void btstack_audio_pico_sink_start_stream(void);

static void btstack_audio_pico_sink_stop_stream(void);

static void btstack_audio_pico_sink_close(void);

static const btstack_audio_sink_t btstack_audio_pico_sink = {
    .init = &btstack_audio_pico_sink_init,
    .set_volume = &btstack_audio_pico_sink_set_volume,
    .start_stream = &btstack_audio_pico_sink_start_stream,
    .stop_stream = &btstack_audio_pico_sink_stop_stream,
    .close = &btstack_audio_pico_sink_close,
};

const btstack_audio_sink_t * btstack_audio_pico_sink_get_instance(void){
    return &btstack_audio_pico_sink;
}

static audio_buffer_pool_t *init_audio(uint32_t sample_frequency, uint8_t channel_count) {

    // num channels requested by application
    btstack_audio_pico_channel_count = channel_count;

    // always use stereo
    btstack_audio_pico_audio_format.format = AUDIO_BUFFER_FORMAT_PCM_S16;
    btstack_audio_pico_audio_format.sample_freq = sample_frequency;
    btstack_audio_pico_audio_format.channel_count = 2;

    btstack_audio_pico_producer_format.format = &btstack_audio_pico_audio_format;
    btstack_audio_pico_producer_format.sample_stride = 2 * 2;

    audio_buffer_pool_t * producer_pool = audio_new_producer_pool(&btstack_audio_pico_producer_format, 3, SAMPLES_PER_BUFFER); // todo correct size

    audio_i2s_config_t config;
    config.data_pin       = PICO_AUDIO_I2S_DATA_PIN;
    config.clock_pin_base = PICO_AUDIO_I2S_CLOCK_PIN_BASE;
    config.dma_channel    = (int8_t) dma_claim_unused_channel(true);
    config.pio_sm         = 0;

    // audio_i2s_setup claims the channel again https://github.com/raspberrypi/pico-extras/issues/48
    dma_channel_unclaim(config.dma_channel);
    const audio_format_t * output_format = audio_i2s_setup(&btstack_audio_pico_audio_format, &config);
    if (!output_format) {
        panic("PicoAudio: Unable to open audio device.\n");
    }

    bool ok = audio_i2s_connect(producer_pool);
    assert(ok);
    (void)ok;

    return producer_pool;
}

static int16_t apply_volume(int16_t sample, uint16_t volume_db){
    int32_t tmp = (sample * volume_db) >> 15;
    return (int16_t) tmp;
}

static void btstack_audio_pico_sink_fill_buffers(void){
    while (true){
        audio_buffer_t * audio_buffer = take_audio_buffer(btstack_audio_pico_audio_buffer_pool, false);
        if (audio_buffer == NULL){
            break;
        }

        int16_t * buffer16 = (int16_t *) audio_buffer->buffer->bytes;
        (*playback_callback)(buffer16, audio_buffer->max_sample_count);

        // duplicate samples for mono
        if (btstack_audio_pico_channel_count == 1){
            int16_t i;
            for (i = SAMPLES_PER_BUFFER - 1 ; i >= 0; i--){
                buffer16[2*i  ] = apply_volume(buffer16[i], btstack_audio_pico_volume_db);
                buffer16[2*i+1] = apply_volume(buffer16[i], btstack_audio_pico_volume_db);
            }
        } else {
            int16_t i;
            for (i = 2*SAMPLES_PER_BUFFER - 1 ; i >= 0; i--){
                buffer16[i] = apply_volume(buffer16[i], btstack_audio_pico_volume_db);
            }
        }

        audio_buffer->sample_count = audio_buffer->max_sample_count;
        give_audio_buffer(btstack_audio_pico_audio_buffer_pool, audio_buffer);
    }
}

static void driver_timer_handler_sink(btstack_timer_source_t * ts){

    // refill
    btstack_audio_pico_sink_fill_buffers();

    // re-set timer
    btstack_run_loop_set_timer(ts, DRIVER_POLL_INTERVAL_MS);
    btstack_run_loop_add_timer(ts);
}

static int btstack_audio_pico_sink_init(
    uint8_t channels,
    uint32_t samplerate, 
    void (*playback)(int16_t * buffer, uint16_t num_samples)
){
    btstack_assert(playback != NULL);
    btstack_assert(channels != 0);

    playback_callback  = playback;

    if (!btstack_audio_pico_audio_buffer_pool) {
        btstack_audio_pico_audio_buffer_pool = init_audio(samplerate, channels);
    }
    return 0;
}

static void btstack_audio_pico_sink_set_volume(uint8_t volume){
    int db_encode_val = ((90 - 0)*(int)volume) / 128;
    btstack_audio_pico_volume = volume;
    btstack_audio_pico_volume_db = db_to_vol[db_encode_val];
    printf("New volume in DB val is 0x%x, db_encode_val = %d\n", btstack_audio_pico_volume_db, db_encode_val);
}

static void btstack_audio_pico_sink_start_stream(void){

    // pre-fill HAL buffers
    btstack_audio_pico_sink_fill_buffers();

    // start timer
    btstack_run_loop_set_timer_handler(&driver_timer_sink, &driver_timer_handler_sink);
    btstack_run_loop_set_timer(&driver_timer_sink, DRIVER_POLL_INTERVAL_MS);
    btstack_run_loop_add_timer(&driver_timer_sink);

    // state
    btstack_audio_pico_sink_active = true;

    audio_i2s_set_enabled(true);
}

static void btstack_audio_pico_sink_stop_stream(void){

    audio_i2s_set_enabled(false);

    // stop timer
    btstack_run_loop_remove_timer(&driver_timer_sink);
    // state
    btstack_audio_pico_sink_active = false;
}

static void btstack_audio_pico_sink_close(void){
    // stop stream if needed
    if (btstack_audio_pico_sink_active){
        btstack_audio_pico_sink_stop_stream();
    }
}
