denisgav/rpi_pico_w_a2dp_sink_demo/Firmware/app/usb_hid_multimedia_keypad/inc/keypad_settings.h

#ifndef KEYPAD_SETTINGS__H
#define KEYPAD_SETTINGS__H

#include <pico/stdlib.h>

//--------------------------------------------------------------------+
// MACRO CONSTANT TYPEDEF PROTOTYPES
//--------------------------------------------------------------------+
typedef struct _keypad_settings_t {
  uint32_t blink_interval_ms;
} keypad_settings_t;


#endif //KEYPAD_SETTINGS__H
