denisgav/rpi_pico_w_a2dp_sink_demo/Firmware/app/sdcard_test/src/main.c

#include <stdio.h>
#include <string.h>

#include <pico/stdlib.h>
//
#include "f_util.h"
#include "ff.h"
//#include "rtc.h"
//
#include "hw_config.h"

int main() {
    char buf[100];
    //time_init();

    // Initialize chosen serial port
    stdio_init_all();

    printf("Hello World!\n");

    // Wait for user to press 'enter' to continue
    printf("\r\nSD card test. Press 'enter' to start.\r\n");
    while (true) {
        buf[0] = getchar();
        if ((buf[0] == '\r') || (buf[0] == '\n')) {
            break;
        }
    }

    // See FatFs - Generic FAT Filesystem Module, "Application Interface",
    // http://elm-chan.org/fsw/ff/00index_e.html
    sd_card_t *pSD = sd_get_by_num(0);
    FRESULT fr = f_mount(&pSD->fatfs, pSD->pcName, 1);
    if (FR_OK != fr) {
        printf("f_mount error: %s (%d)\n", FRESULT_str(fr), fr);
        panic("f_mount error\n");
    };
    FIL fil;
    const char* const filename = "filename.txt";
    fr = f_open(&fil, filename, FA_OPEN_APPEND | FA_WRITE);
    if (FR_OK != fr && FR_EXIST != fr)
        panic("f_open(%s) error: %s (%d)\n", filename, FRESULT_str(fr), fr);
    if (f_printf(&fil, "Hello, world!\n") < 0) {
        printf("f_printf failed\n");
    }
    fr = f_close(&fil);
    if (FR_OK != fr) {
        printf("f_close error: %s (%d)\n", FRESULT_str(fr), fr);
    }
    f_unmount(pSD->pcName);

    printf("Test pass!");
    printf("Goodbye, world!");
    while(true){
        sleep_ms(1000);
    }
}
