denisgav/rpi_pico_w_a2dp_sink_demo/(commit log)

2025-03-26 Add FreeRTOS library. Initial board pinout
2025-03-29 Add buttons handle function
2025-03-29 Add button handling function
2025-03-31 Add more buttons. Update pinout
2025-04-05 Scheme initial commit
    [AudioJack_3.5mm_PJ311.step, BarrelJack-PJ-102AH.step, CR1220-2.stp, LS1205EVD33.stp, SW_PUSH_6mm_H5mm.step, SY8003ADFC.stp, TF-01A.stp, [1]Power.kicad_sch]
2025-04-05 Scheme improvements
    [SW_Btn_XLX.step, [1]Power.kicad_sch, [2]MCU.kicad_sch, [3]PCM5102.kicad_sch, [4]TF_CARD.kicad_sch, [5]Macro_Pad.kicad_sch, [6]I2C_Peripherals.kicad_sch, inmp441.step]
2025-04-05 Minor BOM updates
    [[1]Power.kicad_sch, [2]MCU.kicad_sch, [4]TF_CARD.kicad_sch, [5]Macro_Pad.kicad_sch, [6]I2C_Peripherals.kicad_sch]
2025-04-05 DRC cleanup
    [[1]Power.kicad_sch, [2]MCU.kicad_sch, [3]PCM5102.kicad_sch, [4]TF_CARD.kicad_sch, [5]Macro_Pad.kicad_sch, [6]I2C_Peripherals.kicad_sch, rpi_pico_media_board.kicad_pcb]
2025-04-06 PCB initial placement
    [[2]MCU.kicad_sch, [3]PCM5102.kicad_sch, [5]Macro_Pad.kicad_sch, rpi_pico_media_board.kicad_pcb]
2025-04-07 Very initial PCB layout
    [[1]Power.kicad_sch, [2]MCU.kicad_sch, [3]PCM5102.kicad_sch, rpi_pico_media_board.kicad_pcb]
2025-04-07 minor layout update
    [rpi_pico_media_board.kicad_pcb]
2025-04-07 PCB initial layout
    [rpi_pico_media_board.kicad_pcb]
2025-04-07 Macro Pad routing
    [[2]MCU.kicad_sch, rpi_pico_media_board.kicad_pcb]
2025-04-08 SD Card routing
    [[1]Power.kicad_sch, [2]MCU.kicad_sch, rpi_pico_media_board.kicad_pcb]
2025-04-08 Initial PCB version
    [rpi_pico_media_board.kicad_pcb]
2025-04-09 Minor PCB layout updates
    [rpi_pico_media_board.kicad_pcb]
2025-04-09 Trace length tuning
    [rpi_pico_media_board.kicad_pcb]
2025-04-21 Update directory structure
    [AudioJack_3.5mm_PJ311.step, BarrelJack-PJ-102AH.step, CR1220-2.stp, LS1205EVD33.stp, SW_Btn_XLX.step, SW_PUSH_6mm_H5mm.step, SY8003ADFC.stp, TF-01A.stp]
2025-04-23 first unstable pcf8563 library
    [main.c, pcf8563_i2c.c]
2025-04-26 Manufacture files preparation
    [[1]Power.kicad_sch, [2]MCU.kicad_sch, [3]PCM5102.kicad_sch, [4]TF_CARD.kicad_sch, [5]Macro_Pad.kicad_sch, [6]I2C_Peripherals.kicad_sch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]
2025-04-26 Manufacture files
    [rpi_pico_media_board-B_Cu.gbr, rpi_pico_media_board-B_Mask.gbr, rpi_pico_media_board-B_Paste.gbr, rpi_pico_media_board-B_Silkscreen.gbr, rpi_pico_media_board-Edge_Cuts.gbr, rpi_pico_media_board-F_Cu.gbr, rpi_pico_media_board-F_Mask.gbr, rpi_pico_media_board-F_Paste.gbr]
2025-05-01 update status led indication
2025-05-18 First fixes after board assembly
    [[1]Power.kicad_sch, [2]MCU.kicad_sch, [3]PCM5102.kicad_sch, [4]TF_CARD.kicad_sch, [5]Macro_Pad.kicad_sch, [6]I2C_Peripherals.kicad_sch, rpi_pico_media_board.kicad_pcb, rpi_pico_media_board.kicad_sch]
2025-05-19 Fixes for mic sample rate configuration
    [[6]I2C_Peripherals.kicad_sch]
2025-05-22 Fix firmware for windows
    [btstack_audio_pico.c, main.c, tusb_config.h]
